yonathan-star/orbitscore/bom.csv

Item | Quantity | Unit_USD | Extended_USD | Vendor | URL | Price_status | Notes
Raspberry Pi Pico SC0915 | 1 | 4.00 | 4.00 | DFRobot | https://www.dfrobot.com/product-2187.html | Researched price | Headers required separately
MAX98357A amplifier module | 1 | 5.95 | 5.95 | Adafruit | https://www.adafruit.com/product/3006 | Researched price | External cable connection
4 ohm 3W speaker | 1 | 1.95 | 1.95 | Adafruit | https://www.adafruit.com/product/1314 | Researched price | Confirm mounting frame
940nm IR LED5mm | 6 | 0.75 | 4.50 | Adafruit | https://www.adafruit.com/product/387 | Researched price
BPW85C phototransistor | 6 | 0.79 | 4.74 | DigiKey | https://www.digikey.com/en/products/detail/vishay-semiconductor-opto-division/BPW85C/4071266 | Researched price | Live DigiKey cart price for six: $4.74, before shipping/tariff
HC14 DIP14 pack of3 | 1 | 9.99 | 9.99 | SunFounder | https://www.sunfounder.com/products/74hc14-hex-schmitt-trigger-inverters-dip14 | Researched price | Only1 IC used
10k linear panel pot | 2 | 0.95 | 1.90 | Adafruit | https://www.adafruit.com/product/562 | Researched price
6mm tactile switch pack20 | 1 | 2.50 | 2.50 | Adafruit | https://www.adafruit.com/product/367 | Researched price | 6 used
100nF capacitor pack10 | 1 | 1.95 | 1.95 | Adafruit | https://www.adafruit.com/product/753 | Researched price | 2 used; bend leads to5mm footprint
Resistors220R x6 10k x7 100k x1 1k x2 | 1 | 3.20 | 3.20 | Adafruit | https://www.adafruit.com/category/837 | Budget allowance not quote | Four 25-packs: 220R,10k,100k,1k; prices0.75,0.75,0.95,0.75
10nF capacitors x2 and470uF10V x1 | 1 | 2.00 | 2.00 | LCSC / Jameco — estimate | https://www.lcsc.com/product-detail/C6715922.html | Budget allowance not quote | UNQUOTED allowance; final exact parts/cart required
3mm green LEDs x2 | 1 | 1.00 | 1.00 | SparkFun | https://www.sparkfun.com/led-basic-green-3mm.html | Budget allowance not quote | Two LEDs at0.50 each
Headers sockets and harness wire | 1 | 7.85 | 7.85 | Adafruit | https://www.adafruit.com/product/5583 | Budget allowance not quote | Pico sockets0.95, male red header pack4.95, harness1.95; products5583,4151,1950
Three PCB designs fabrication | 1 | 12.00 | 12.00 | JLCPCB — estimate | https://cart.jlcpcb.com/quote | Budget allowance not quote | Controller quote4.00 for5; other designs and delivery not final
Opaque filament and disc stock | 1 | 20.00 | 20.00 | Protopasta | https://proto-pasta.com/pages/sponsorship | Budget allowance not quote | Full1kg spool listed20; cart/shipping not captured
Fasteners washers and spacers | 1 | 12.99 | 12.99 | Pyrodrone | https://pyrodrone.com/collections/m3 | Budget allowance not quote | M3 bolt kit listed12.99; fastener lengths/spacers and cart still require verification
5V1A USB supply and cable | 1 | 8.90 | 8.90 | Adafruit | https://www.adafruit.com/product/501 | Budget allowance not quote | Adapter5.95 plus MicroUSB cable2.95
