yonathan-star/orbitscore/mechanical/pod_base.stl

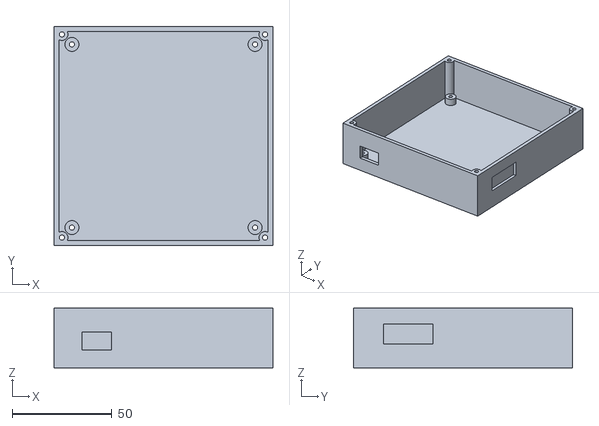
[picture p3: CAD file, 2026-10-26]
mechanical/pod_base.stl
110.0 x 110.0 x 30.0
