yonathan-star/orbitscore/mechanical/plunger.stl

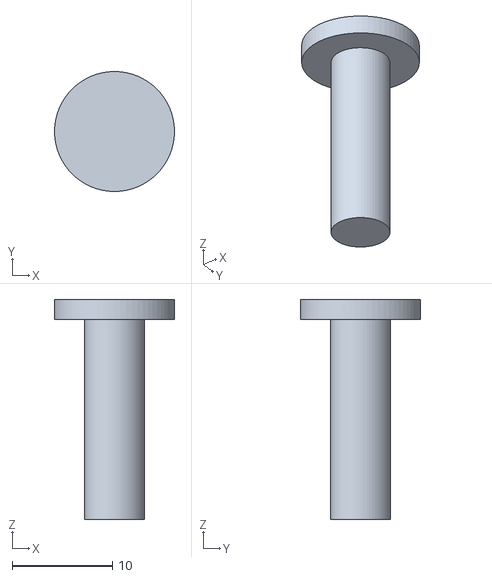
[picture p4: CAD file, 2026-10-26]
mechanical/plunger.stl
12.0 x 12.0 x 22.0
