yonathan-star/orbitscore/mechanical/emitters-board.step

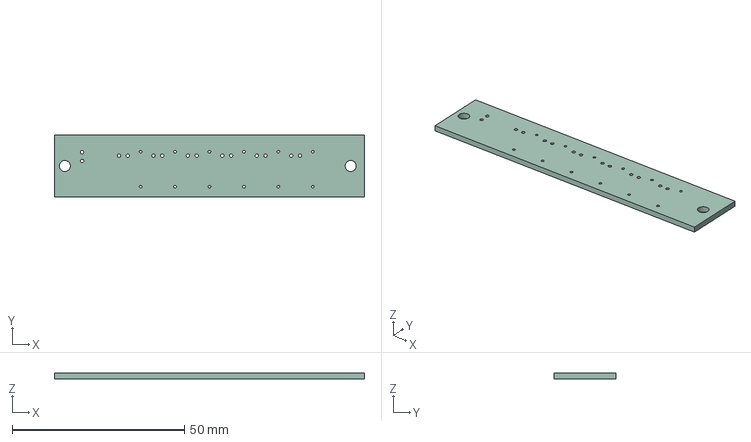
[picture p5: CAD file, 2026-10-26]
mechanical/emitters-board.step
90.0 x 18.0 x 1.60 mm
