yonathan-star/orbitscore/mechanical/pod_lid.stl

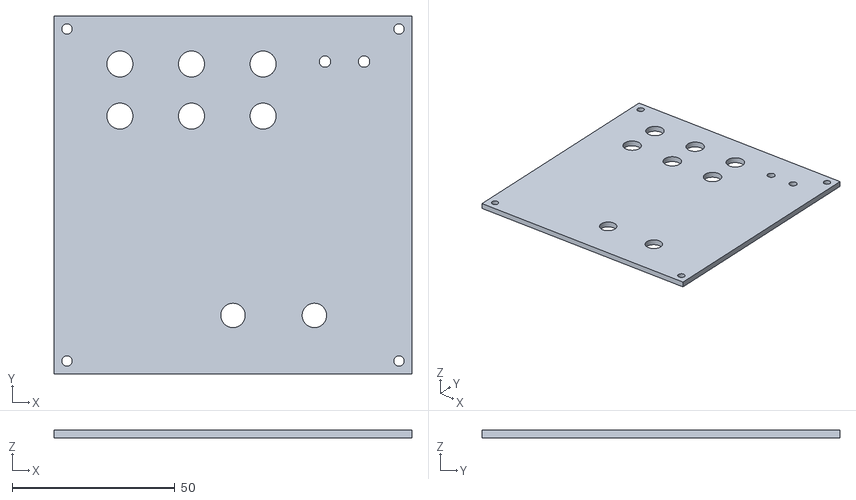
[picture p6: CAD file, 2026-10-26]
mechanical/pod_lid.stl
110.0 x 110.0 x 2.40
