yonathan-star/orbitscore/mechanical/disc.stl

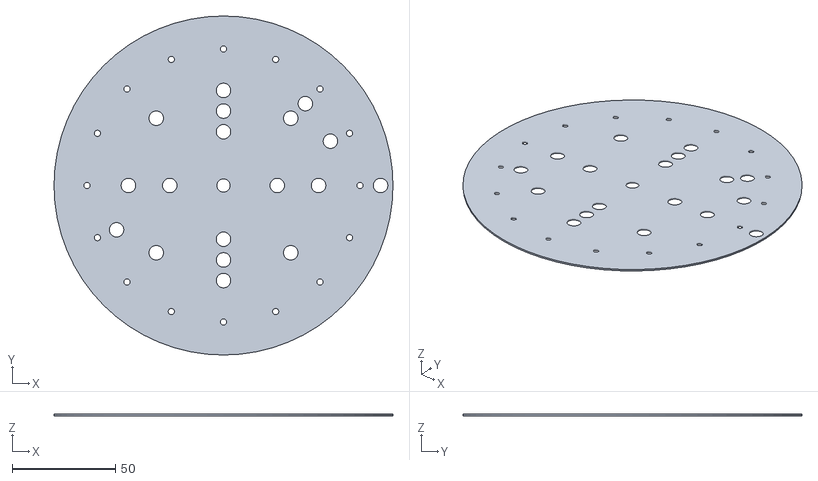
[picture p7: CAD file, 2026-10-26]
mechanical/disc.stl
164.0 x 164.0 x 0.8
