yonathan-star/orbitscore/mechanical/base.stl

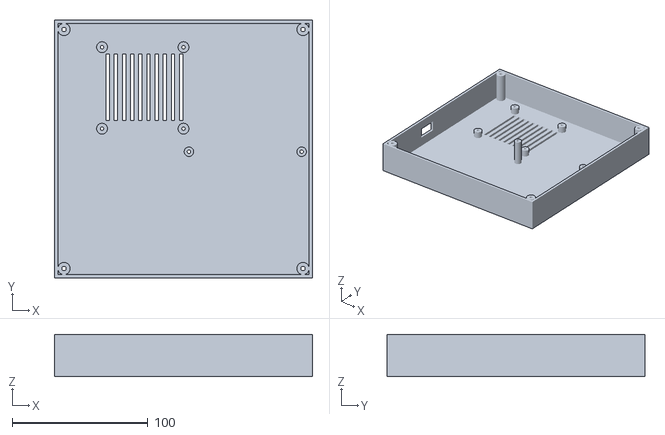
[picture p8: CAD file, 2026-10-26]
mechanical/base.stl
190.0 x 190.0 x 31.0
