yonathan-star/orbitscore/mechanical/deck.stl

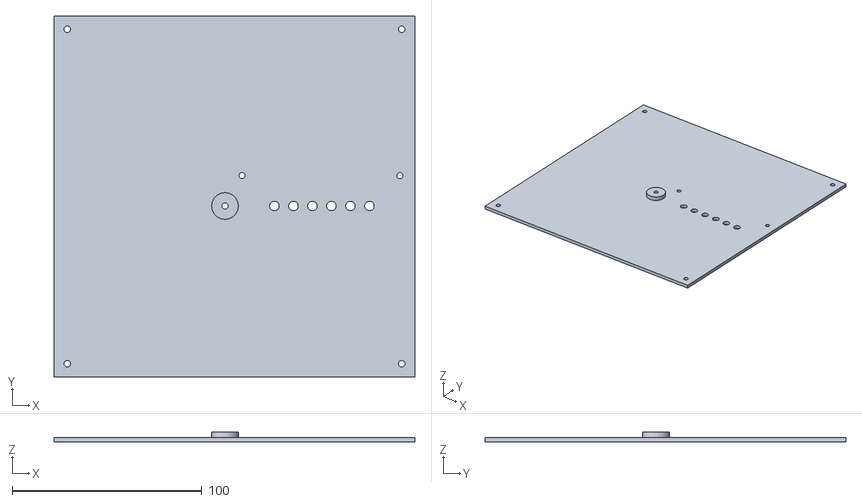
[picture p9: CAD file, 2026-10-26]
mechanical/deck.stl
190.0 x 190.0 x 5.40
