yonathan-star/orbitscore/mechanical/hub.stl

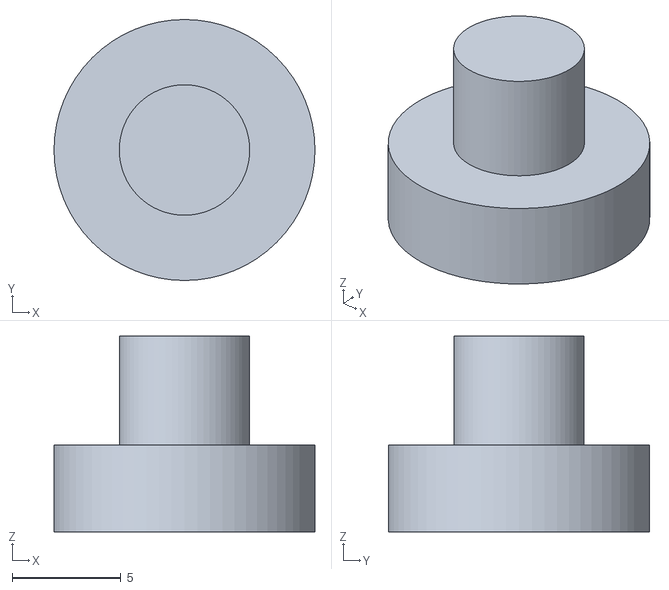
[picture p10: CAD file, 2026-10-26]
mechanical/hub.stl
12.0 x 12.0 x 9.00
