yonathan-star/orbitscore/mechanical/bridge.stl

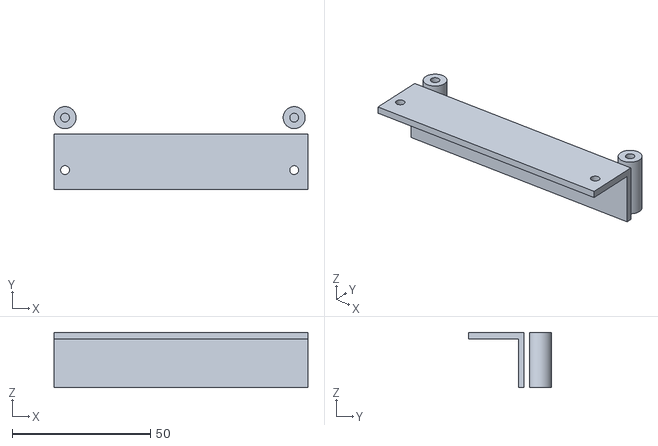
[picture p11: CAD file, 2026-10-26]
mechanical/bridge.stl
92.0 x 30.0 x 20.0
