yonathan-star/orbitscore/mechanical/controller-board.step

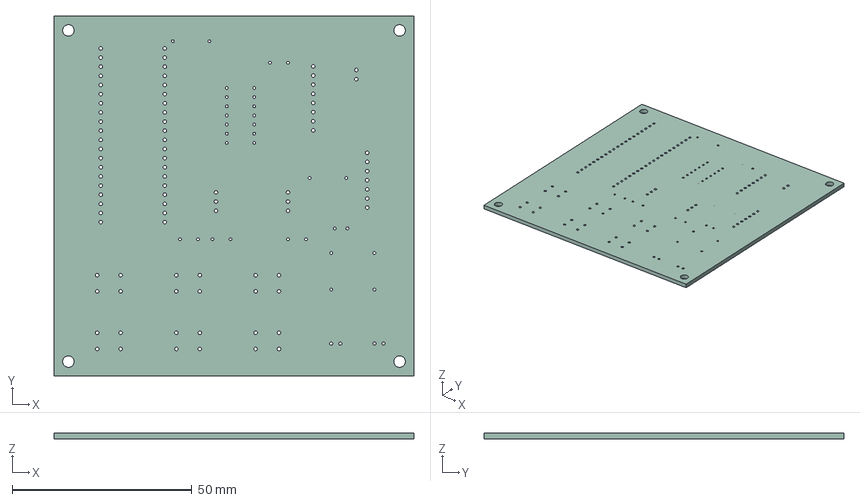
[picture p12: CAD file, 2026-10-26]
mechanical/controller-board.step
100.0 x 100.0 x 1.60 mm
