yonathan-star/orbitscore/(list of files, cad)

Other CAD files:
mechanical/reader-board.step
