yonathan-star/orbitscore/hardware/reader/reader.kicad_pcb

## KiCad design hardware/reader/reader.kicad_pcb (2026-10-26)

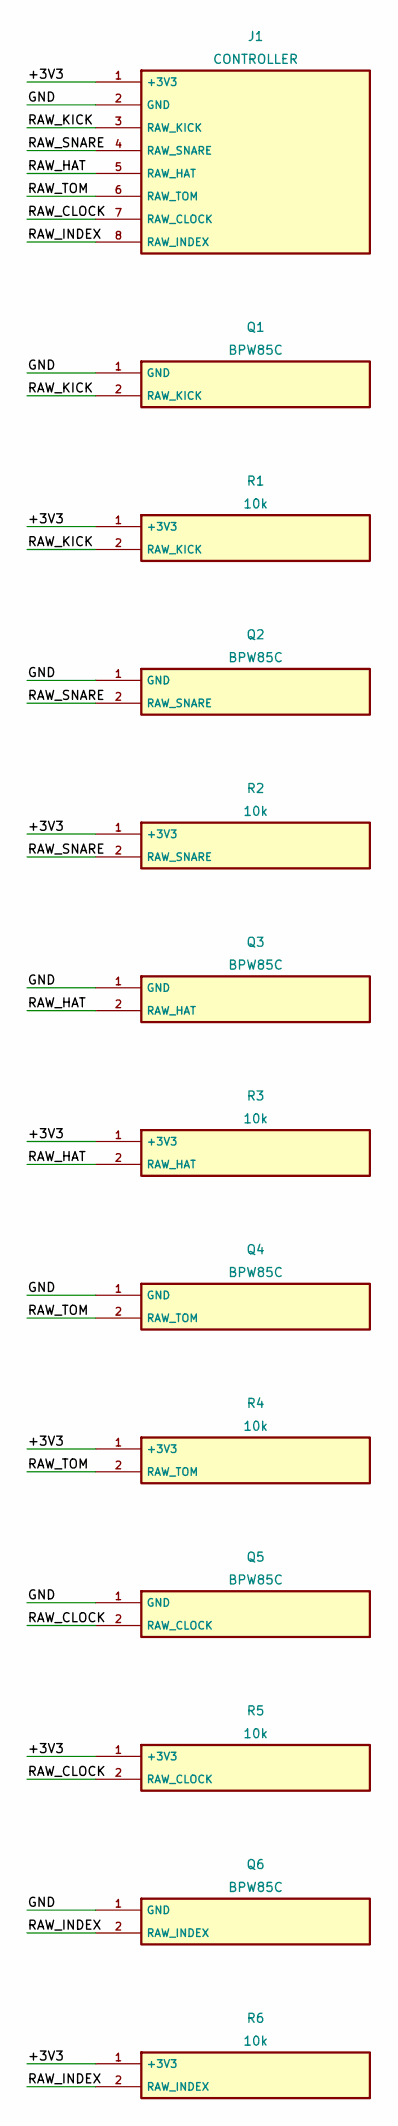
[picture p13: schematic reader.kicad_sch, OrbitScore - reader]

Parts:
J1: CONTROLLER; PinHeader_2x04_P2.54mm_Vertical
Q1, Q2, Q3, Q4, Q5, Q6: BPW85C
R1, R2, R3, R4, R5, R6: 10k; R_Axial_DIN0207_L6.3mm_D2.5mm_P10.16mm_Horizontal

Connections:
+3V3: J1.1 (+3V3), R1.1 (+3V3), R2.1 (+3V3), R3.1 (+3V3), R4.1 (+3V3), R5.1 (+3V3), R6.1 (+3V3)
GND: J1.2 (GND), Q1.1 (GND), Q2.1 (GND), Q3.1 (GND), Q4.1 (GND), Q5.1 (GND), Q6.1 (GND)
RAW_CLOCK: J1.7 (RAW_CLOCK), Q5.2 (RAW_CLOCK), R5.2 (RAW_CLOCK)
RAW_HAT: J1.5 (RAW_HAT), Q3.2 (RAW_HAT), R3.2 (RAW_HAT)
RAW_INDEX: J1.8 (RAW_INDEX), Q6.2 (RAW_INDEX), R6.2 (RAW_INDEX)
RAW_KICK: J1.3 (RAW_KICK), Q1.2 (RAW_KICK), R1.2 (RAW_KICK)
RAW_SNARE: J1.4 (RAW_SNARE), Q2.2 (RAW_SNARE), R2.2 (RAW_SNARE)
RAW_TOM: J1.6 (RAW_TOM), Q4.2 (RAW_TOM), R4.2 (RAW_TOM)

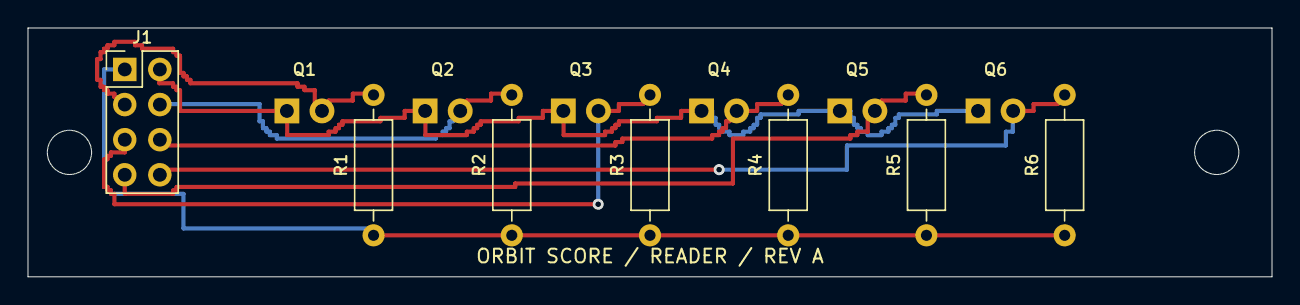
[picture p14: board reader.kicad_pcb from above]

Board: 2 copper layers, 90.0 x 18.0 mm, 15 parts (0 on the bottom side), 8 nets.

Other parts of the board:
H39, H869: MountingHole_3.2mm
