yonathan-star/orbitscore/hardware/emitters/emitters.kicad_pcb

## KiCad design hardware/emitters/emitters.kicad_pcb (2026-10-26)

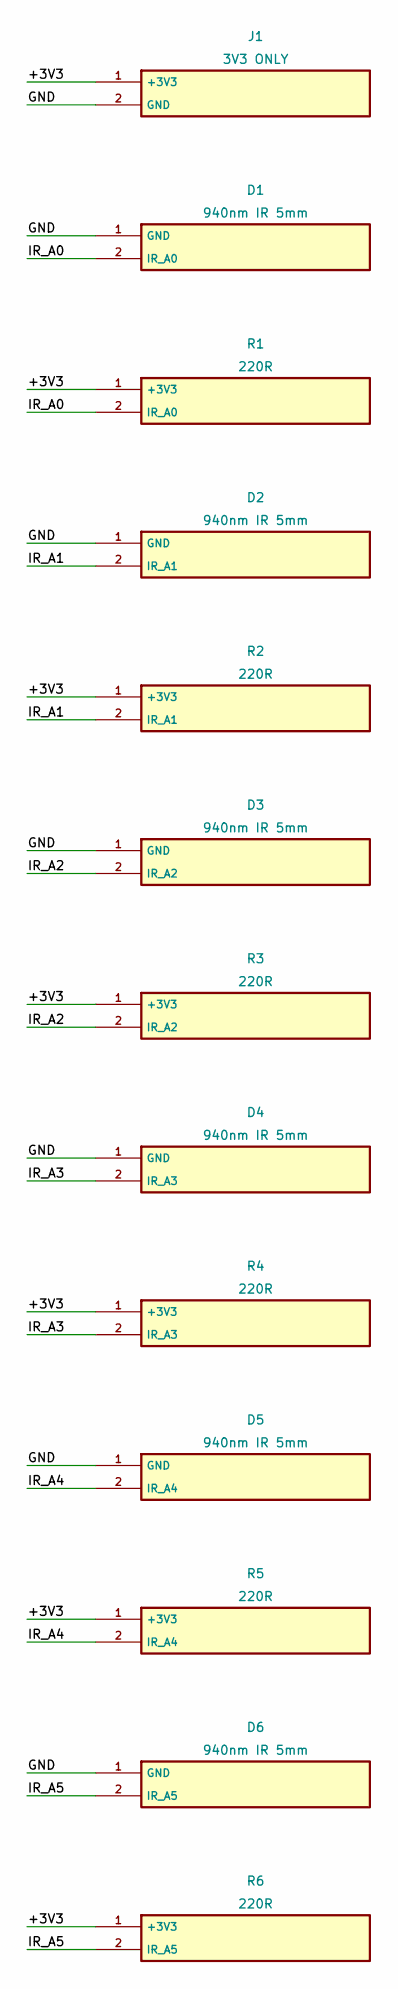
[picture p15: schematic emitters.kicad_sch, OrbitScore - emitters]

Parts:
D1, D2, D3, D4, D5, D6: 940nm IR 5mm; IR_5mm
J1: 3V3 ONLY; PinHeader_1x02_P2.54mm_Vertical
R1, R2, R3, R4, R5, R6: 220R; R_Axial_DIN0207_L6.3mm_D2.5mm_P10.16mm_Horizontal

Connections:
+3V3: J1.1 (+3V3), R1.1 (+3V3), R2.1 (+3V3), R3.1 (+3V3), R4.1 (+3V3), R5.1 (+3V3), R6.1 (+3V3)
GND: D1.1 (GND), D2.1 (GND), D3.1 (GND), D4.1 (GND), D5.1 (GND), D6.1 (GND), J1.2 (GND)
IR_A0: D1.2 (IR_A0), R1.2 (IR_A0)
IR_A1: D2.2 (IR_A1), R2.2 (IR_A1)
IR_A2: D3.2 (IR_A2), R3.2 (IR_A2)
IR_A3: D4.2 (IR_A3), R4.2 (IR_A3)
IR_A4: D5.2 (IR_A4), R5.2 (IR_A4)
IR_A5: D6.2 (IR_A5), R6.2 (IR_A5)

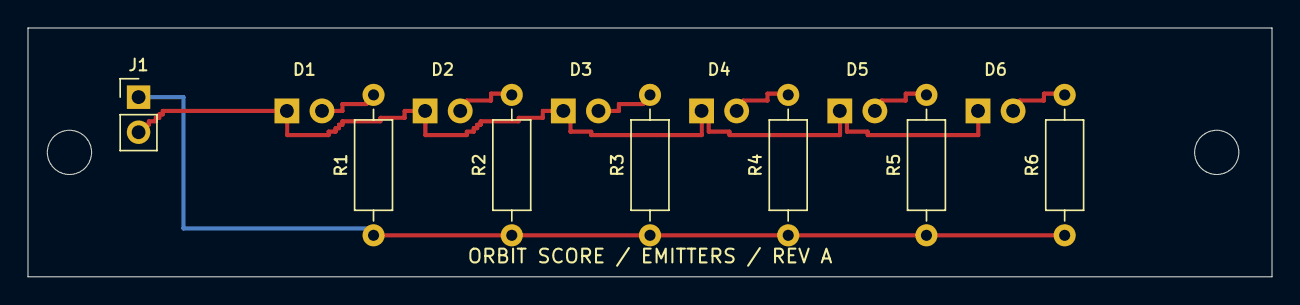
[picture p16: board emitters.kicad_pcb from above]

Board: 2 copper layers, 90.0 x 18.0 mm, 15 parts (0 on the bottom side), 8 nets.

Other parts of the board:
H39, H869: MountingHole_3.2mm
