yonathan-star/orbitscore/hardware/controller/controller.kicad_pcb

## KiCad design hardware/controller/controller.kicad_pcb (2026-10-26)

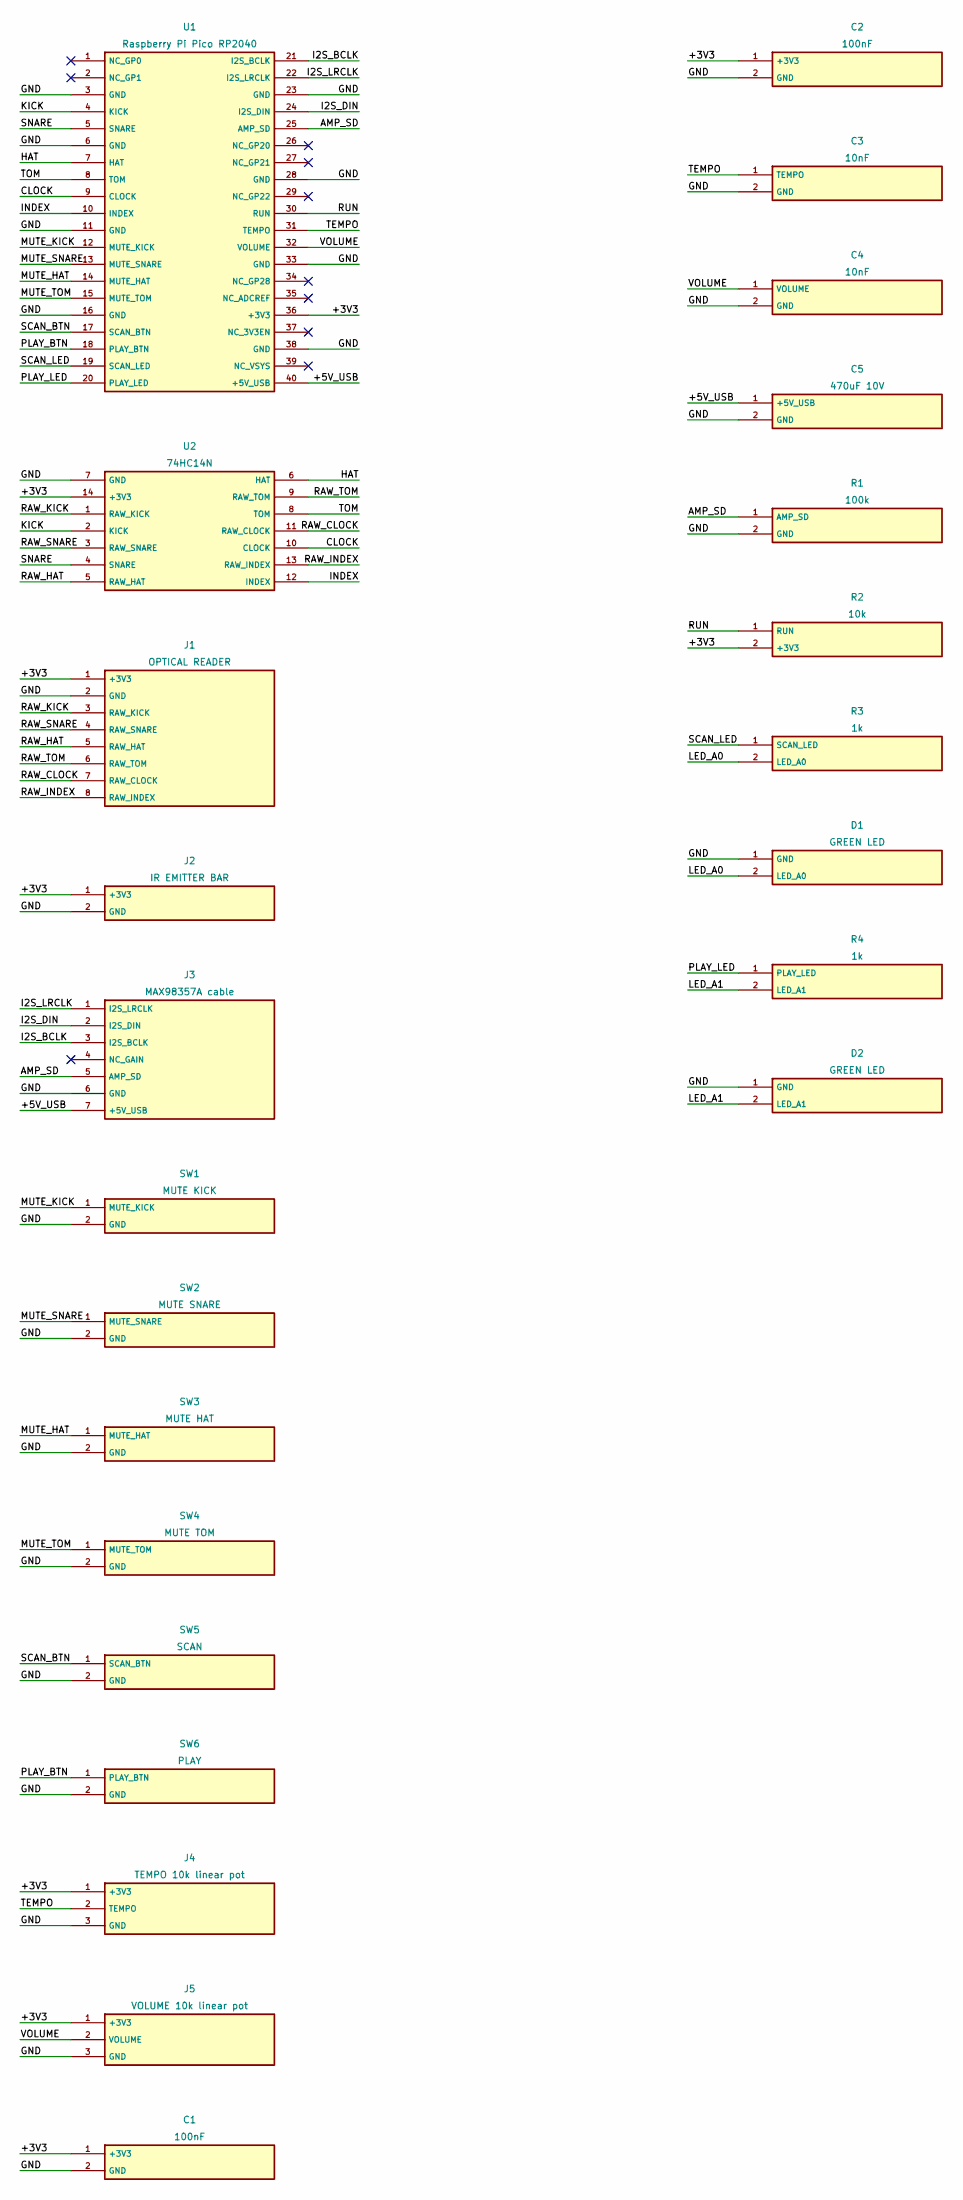
[picture p17: schematic controller.kicad_sch, OrbitScore - controller]

Parts:
C1, C2: 100nF; C_Disc_D5.0mm_W2.5mm_P5.00mm
C3, C4: 10nF; C_Disc_D5.0mm_W2.5mm_P5.00mm
C5: 470uF 10V; CP_Radial_D8.0mm_P3.50mm
D1, D2: GREEN LED; LED_D3.0mm
J1: OPTICAL READER; PinHeader_1x08_P2.54mm_Vertical
J2: IR EMITTER BAR; PinHeader_1x02_P2.54mm_Vertical
J3: MAX98357A cable; PinHeader_1x07_P2.54mm_Vertical
J4: TEMPO 10k linear pot; PinHeader_1x03_P2.54mm_Vertical
J5: VOLUME 10k linear pot; PinHeader_1x03_P2.54mm_Vertical
R1: 100k; R_Axial_DIN0207_L6.3mm_D2.5mm_P10.16mm_Horizontal
R2: 10k; R_Axial_DIN0207_L6.3mm_D2.5mm_P10.16mm_Horizontal
R3, R4: 1k; R_Axial_DIN0207_L6.3mm_D2.5mm_P10.16mm_Horizontal
SW1: MUTE KICK; Button_6mm
SW2: MUTE SNARE; Button_6mm
SW3: MUTE HAT; Button_6mm
SW4: MUTE TOM; Button_6mm
SW5: SCAN; Button_6mm
SW6: PLAY; Button_6mm
U1: Raspberry Pi Pico RP2040; Pico_Socket
U2: 74HC14N; DIP-14_W7.62mm

Connections:
+3V3: C1.1 (+3V3), C2.1 (+3V3), J1.1 (+3V3), J2.1 (+3V3), J4.1 (+3V3), J5.1 (+3V3), R2.2 (+3V3), U1.36 (+3V3), U2.14 (+3V3)
+5V_USB: C5.1 (+5V_USB), J3.7 (+5V_USB), U1.40 (+5V_USB)
AMP_SD: J3.5 (AMP_SD), R1.1 (AMP_SD), U1.25 (AMP_SD)
CLOCK: U1.9 (CLOCK), U2.10 (CLOCK)
GND: C1.2 (GND), C2.2 (GND), C3.2 (GND), C4.2 (GND), C5.2 (GND), D1.1 (GND), D2.1 (GND), J1.2 (GND), J2.2 (GND), J3.6 (GND), J4.3 (GND), J5.3 (GND), R1.2 (GND), SW1.2 (GND), SW2.2 (GND), SW3.2 (GND), SW4.2 (GND), SW5.2 (GND), SW6.2 (GND), U1.3 (GND), U1.6 (GND), U1.11 (GND), U1.16 (GND), U1.23 (GND), U1.28 (GND), U1.33 (GND), U1.38 (GND), U2.7 (GND)
HAT: U1.7 (HAT), U2.6 (HAT)
I2S_BCLK: J3.3 (I2S_BCLK), U1.21 (I2S_BCLK)
I2S_DIN: J3.2 (I2S_DIN), U1.24 (I2S_DIN)
I2S_LRCLK: J3.1 (I2S_LRCLK), U1.22 (I2S_LRCLK)
INDEX: U1.10 (INDEX), U2.12 (INDEX)
KICK: U1.4 (KICK), U2.2 (KICK)
LED_A0: D1.2 (LED_A0), R3.2 (LED_A0)
LED_A1: D2.2 (LED_A1), R4.2 (LED_A1)
MUTE_HAT: SW3.1 (MUTE_HAT), U1.14 (MUTE_HAT)
MUTE_KICK: SW1.1 (MUTE_KICK), U1.12 (MUTE_KICK)
MUTE_SNARE: SW2.1 (MUTE_SNARE), U1.13 (MUTE_SNARE)
MUTE_TOM: SW4.1 (MUTE_TOM), U1.15 (MUTE_TOM)
PLAY_BTN: SW6.1 (PLAY_BTN), U1.18 (PLAY_BTN)
PLAY_LED: R4.1 (PLAY_LED), U1.20 (PLAY_LED)
RAW_CLOCK: J1.7 (RAW_CLOCK), U2.11 (RAW_CLOCK)
RAW_HAT: J1.5 (RAW_HAT), U2.5 (RAW_HAT)
RAW_INDEX: J1.8 (RAW_INDEX), U2.13 (RAW_INDEX)
RAW_KICK: J1.3 (RAW_KICK), U2.1 (RAW_KICK)
RAW_SNARE: J1.4 (RAW_SNARE), U2.3 (RAW_SNARE)
RAW_TOM: J1.6 (RAW_TOM), U2.9 (RAW_TOM)
RUN: R2.1 (RUN), U1.30 (RUN)
SCAN_BTN: SW5.1 (SCAN_BTN), U1.17 (SCAN_BTN)
SCAN_LED: R3.1 (SCAN_LED), U1.19 (SCAN_LED)
SNARE: U1.5 (SNARE), U2.4 (SNARE)
TEMPO: C3.1 (TEMPO), J4.2 (TEMPO), U1.31 (TEMPO)
TOM: U1.8 (TOM), U2.8 (TOM)
VOLUME: C4.1 (VOLUME), J5.2 (VOLUME), U1.32 (VOLUME)

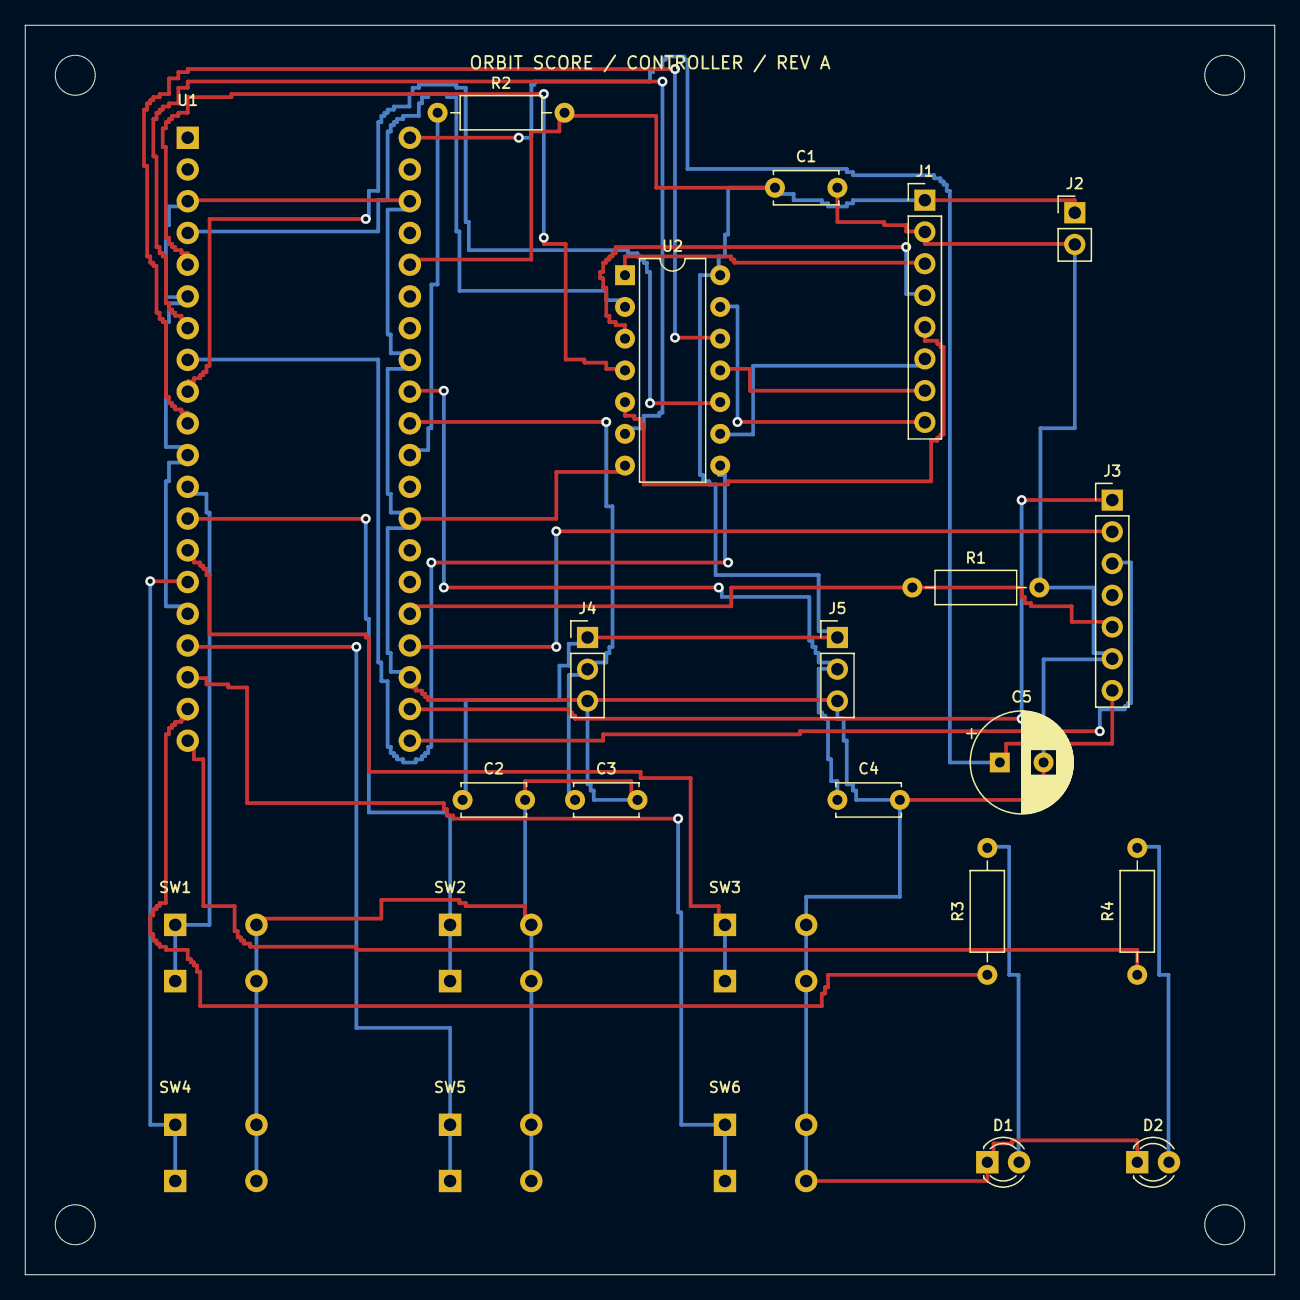
[picture p18: board controller.kicad_pcb from above]

Board: 2 copper layers, 100.0 x 100.0 mm, 28 parts (0 on the bottom side), 32 nets.

Other parts of the board:
H44, H496, H964, H9696: MountingHole_3.2mm
