yonathan-star/orbitscore/(commit log)

2026-10-26 Add OrbitScore revision A design files
    [base.stl, bom.csv, bridge.stl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]
2026-10-26 Show controller board alongside enclosure in project overview
2026-10-26 Update supplier prices and explicitly document remaining quote limitations
    [bom.csv]
